HusseinKhodor03/posture-pad/docs/Functional Decomposition.pdf

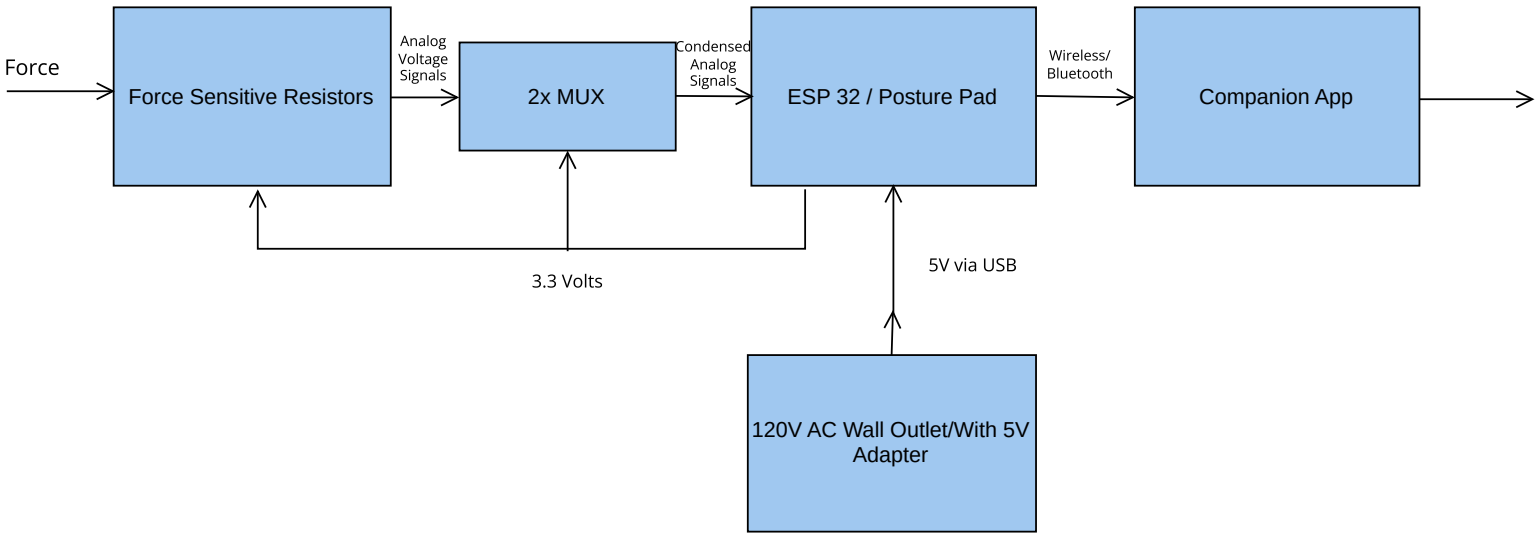
[picture p4: figure]
120V AC Wall Outlet/With 5V Adapter; Wireless/ Bluetooth; Analog Voltage Signals; Condensed Analog Signals; 5V via USB; 3.3 Volts

Force Sensitive Resistors | 2x MUX | ESP 32 / Posture Pad | Companion App

Display of Mapped Force
Gradient

Input Downward Force

Force Sensitive Resistors

Module | Force Sensitive Resistors

Input

Output

Funtionality Will be used to gather downward force from user standing on it

FSR 402 Range: 0N - 20N
FSR 406 Range: 0N - 20N
Power: 3.3V

MUX

Module | Multiplexers

Input

Output | 1 data Output
Funtionality | To be able to be able use all outputs given from using 18 FSRs.

16 data Input
Power: 2V - 6V

A range of Force ranging
from 0 - 20N

ESP 32

Module | ESP 32

Input

Output | 11 I/O Pins
Funtionality | To gather data from FSRs and use the data for our output display.

Power 3.3V
11 I/O Pins

Companion App

Module | Web Application

Input

Output Mapped gradient display of force

Funtionality

To display for user what their standing patterns are through a mapped gradient of their foot impressions.

USB Input from ESP 32

Power Supply

Module | Power Supply

Input

Output | 3.3V
Funtionality | To be compatible to power our ESP32, MUX's and FSRs.

120VAC through a 3.3V
adapter

Force Applied from Standing

3V Volts

ESP 32 | Display colored gradient
Inputs | - 3V from the Wall outlet - Data from standing on FSR.
Outputs | - Mapped display of color gradient to showing force application.
Functionality | - Input force is used to display on an output color gradient of a user's standing patterns and foot impressions.
