HusseinKhodor03/posture-pad/hardware/pcb/Posture Pad PCB CAD.pdf

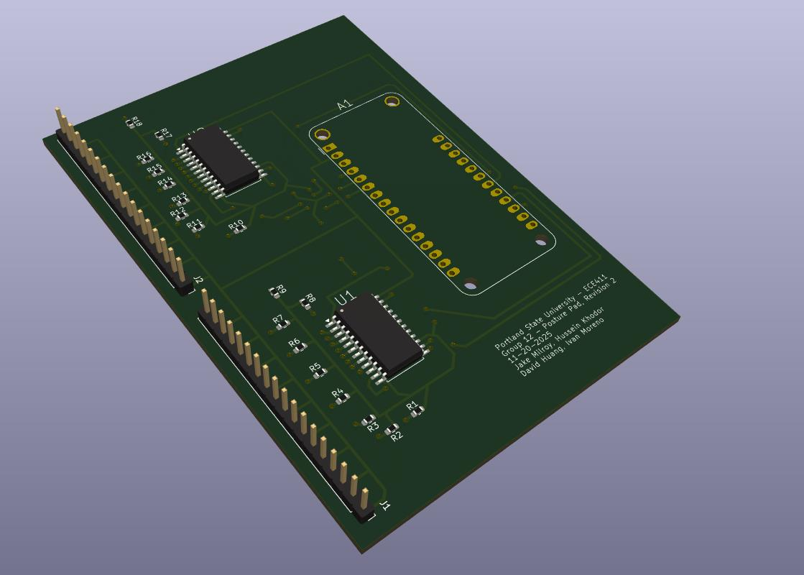
[picture p6: page 1]
