HusseinKhodor03/posture-pad/docs/Bill of Materials.xlsx

Bill Of Materials for: Team 12 - Posture Pad
Last modified: 2025-11-11
PCB version: 1.0
BOM revision: 1.0r0
Qty | Reference Designators | Mfr | Mfr Part Number | Description | Dist | Dist Part Number | Cost Ea. | Cost Total
12 | FSR 402 | Interlink Electronics | 30-81794 | Small, round force-sensitive resistor for pressure sensing | Digi-Key | 1027-1001-ND | $6.39 | $76.68
15 | FSR 406 | Interlink Electronics | 30-73258 | Larger, rectangular force-sensitive resistor for wider-area pressure sensing | Digi-Key | 1027-1002-ND | $10.08 | $151.20
1 | Foam Pad | McMASTER-CARR | 7756T122 | Soft layer providing cushioning and even pressure distribution for the sensing surface | McMASTER-CARR | 7756T122 | $23.88 | $23.88
2 | Plastic Sheets | McMASTER-CARR | 85815K221 | Rigid layers used to protect sensors and help distribute applied force evenly | McMASTER-CARR | 85815K221 | $3.08 | $6.16
4 | Analog/Digital MUX Breakout | SparkFun | CD74HC4067 | 16-channel analog/digital multiplexer for expanding input or output pins | SparkFun | CD74HC4067 | $6.50 | $26.00
 |  |  |  |  |  |  | TOTAL: | $283.92
VERSION INFO
Rev | Date
1.0r0 | 2025-11-11
