HusseinKhodor03/posture-pad/hardware/schematic/Posture Pad Updated Schematic.pdf

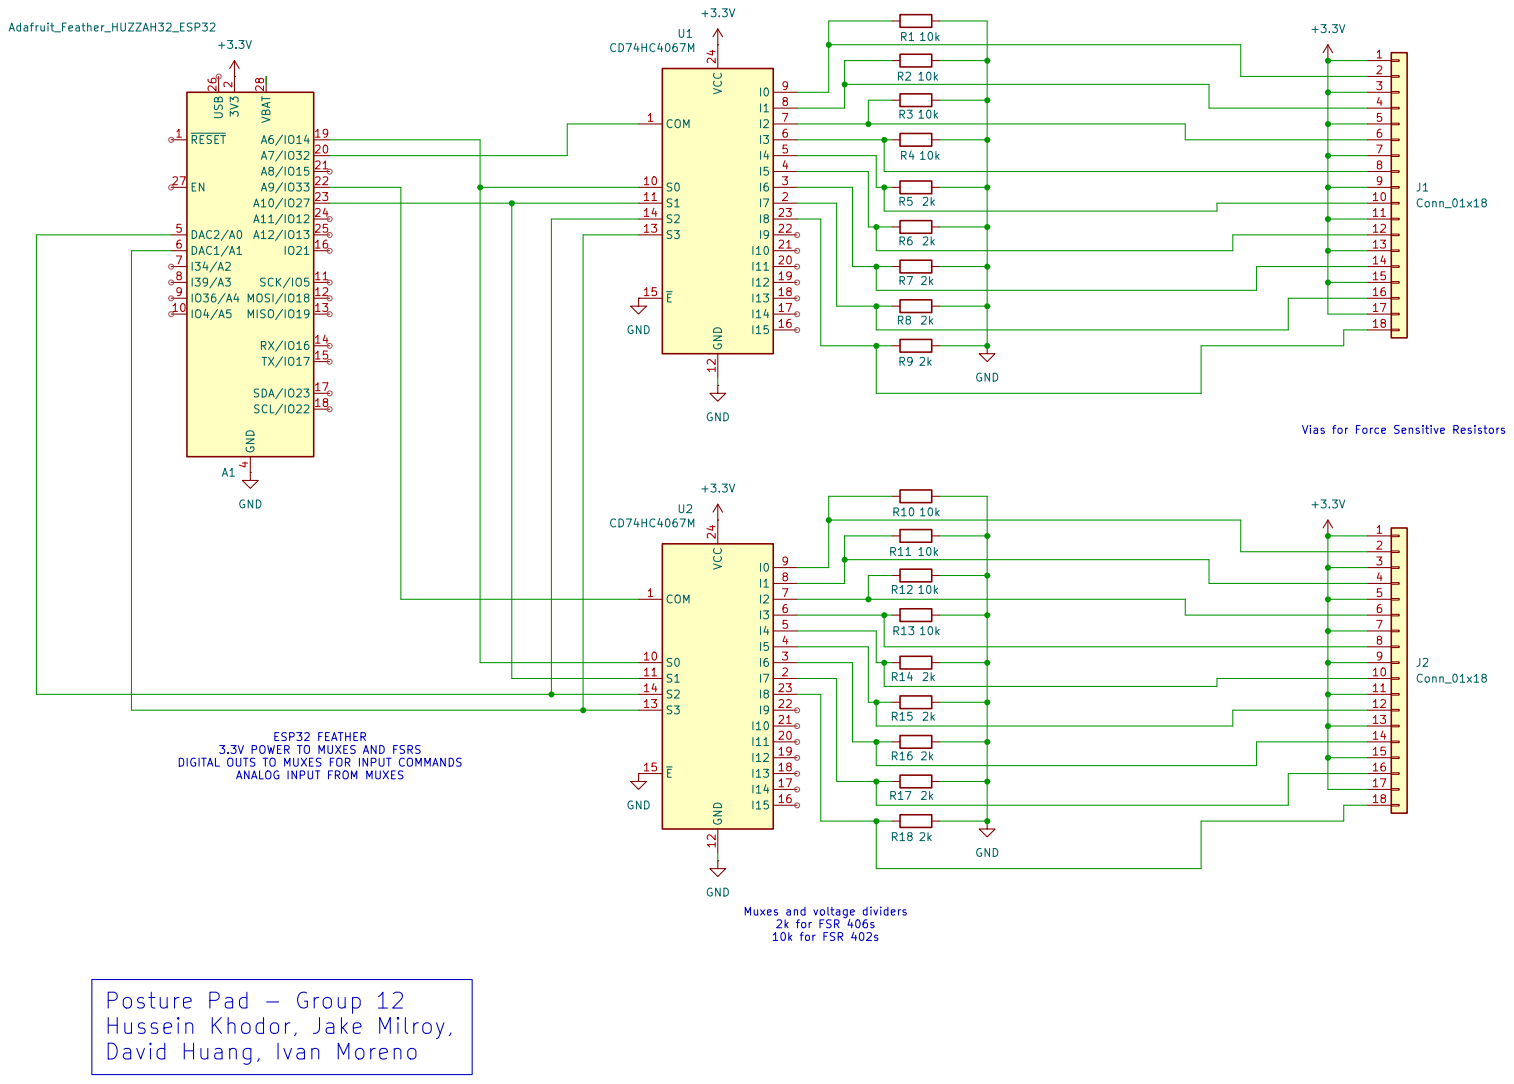
[picture p9: page 1]
