HusseinKhodor03/posture-pad/hardware/schematic/Posture Pad Preliminary Schematic.pdf

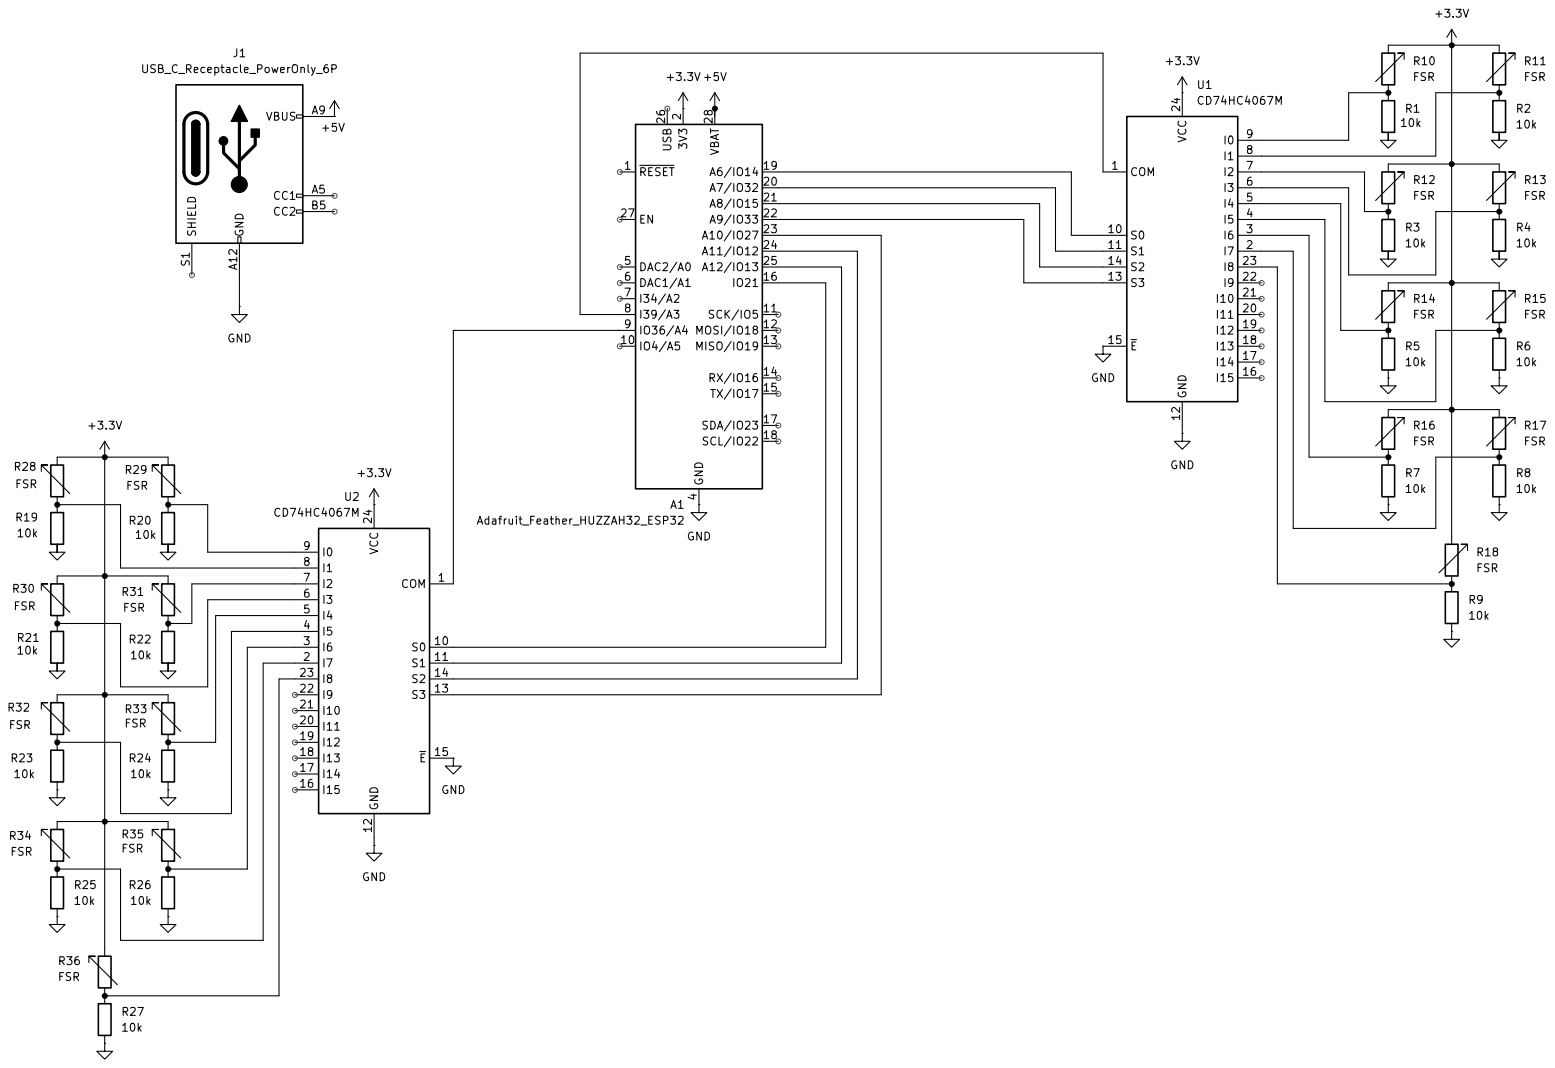
[picture p10: page 1]
