HusseinKhodor03/posture-pad/hardware/kicad/PosturePad/PosturePad.kicad_pcb

## KiCad design hardware/kicad/PosturePad/PosturePad.kicad_pcb (2025-11-22)

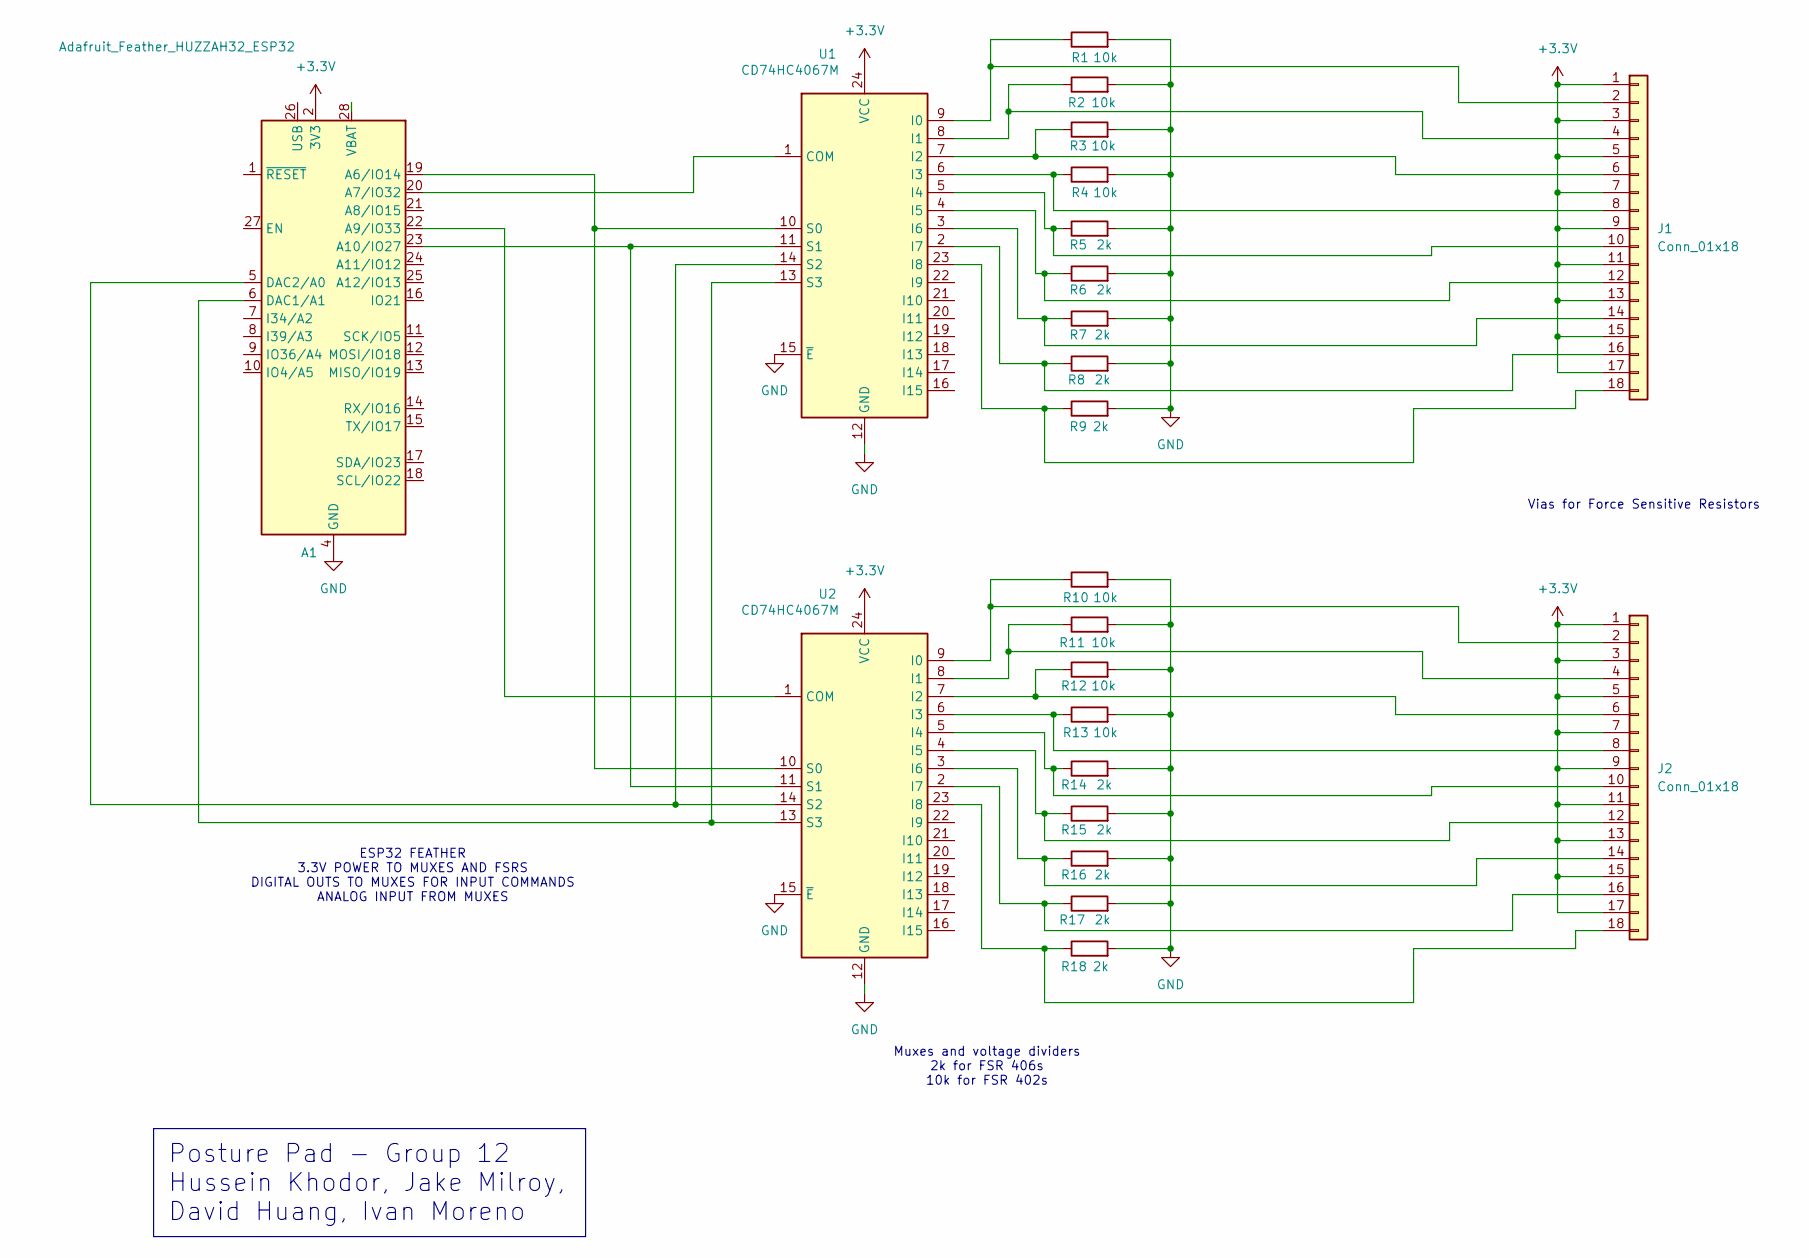
[picture p11: schematic PosturePad.kicad_sch, Posture Pad - Group 12]

Parts:
A1: Adafruit_Feather_HUZZAH32_ESP32; Adafruit_Feather_WithMountingHoles
J1, J2: Conn_01x18; PinHeader_1x18_P2.54mm_Vertical
R1, R2, R3, R4, R10, R11, R12, R13: 10k; R_0603_1608Metric
R5, R6, R7, R8, R9, R14, R15, R16, R17, R18: 2k; R_0603_1608Metric
U1, U2: CD74HC4067M; SOIC-24W_7.5x15.4mm_P1.27mm

Connections:
+3.3V: A1.2 (3V3), J1.1, J1.3, J1.5, J1.7, J1.9, J1.11, J1.13, J1.15, J1.17, J2.1, J2.3, J2.5, J2.7, J2.9, J2.11, J2.13, J2.15, J2.17, U1.24 (VCC), U2.24 (VCC)
GND: A1.4 (GND), R1.2, R2.2, R3.2, R4.2, R5.2, R6.2, R7.2, R8.2, R9.2, R10.2, R11.2, R12.2, R13.2, R14.2, R15.2, R16.2, R17.2, R18.2, U1.12 (GND), U1.15 (~E), U2.12 (GND), U2.15 (~E)
unnamed: A1.19 (A6/IO14), U1.10 (S0), U2.10 (S0)
unnamed: A1.20 (A7/IO32), U1.1 (COM)
unnamed: A1.22 (A9/IO33), U2.1 (COM)
unnamed: A1.23 (A10/IO27), U1.11 (S1), U2.11 (S1)
unnamed: A1.6 (DAC1/A1), U1.13 (S3), U2.13 (S3)
unnamed: A1.5 (DAC2/A0), U1.14 (S2), U2.14 (S2)
unnamed: J1.2, R1.1, U1.9 (I0)
unnamed: J1.4, R2.1, U1.8 (I1)
unnamed: J1.6, R3.1, U1.7 (I2)
unnamed: J1.8, R4.1, U1.6 (I3)
unnamed: J1.10, R5.1, U1.5 (I4)
unnamed: J1.12, R6.1, U1.4 (I5)
unnamed: J1.14, R7.1, U1.3 (I6)
unnamed: J1.16, R8.1, U1.2 (I7)
unnamed: J1.18, R9.1, U1.23 (I8)
unnamed: J2.2, R10.1, U2.9 (I0)
unnamed: J2.4, R11.1, U2.8 (I1)
unnamed: J2.6, R12.1, U2.7 (I2)
unnamed: J2.8, R13.1, U2.6 (I3)
unnamed: J2.10, R14.1, U2.5 (I4)
unnamed: J2.12, R15.1, U2.4 (I5)
unnamed: J2.14, R16.1, U2.3 (I6)
unnamed: J2.16, R17.1, U2.2 (I7)
unnamed: J2.18, R18.1, U2.23 (I8)

Notes on the sheet:
Posture Pad - Group 12 Hussein Khodor, Jake Milroy, David Huang, Ivan Moreno
Muxes and voltage dividers 2k for FSR 406s 10k for FSR 402s
Vias for Force Sensitive Resistors
ESP32 FEATHER 3.3V POWER TO MUXES AND FSRS DIGITAL OUTS TO MUXES FOR INPUT COMMANDS ANALOG INPUT FROM MUXES

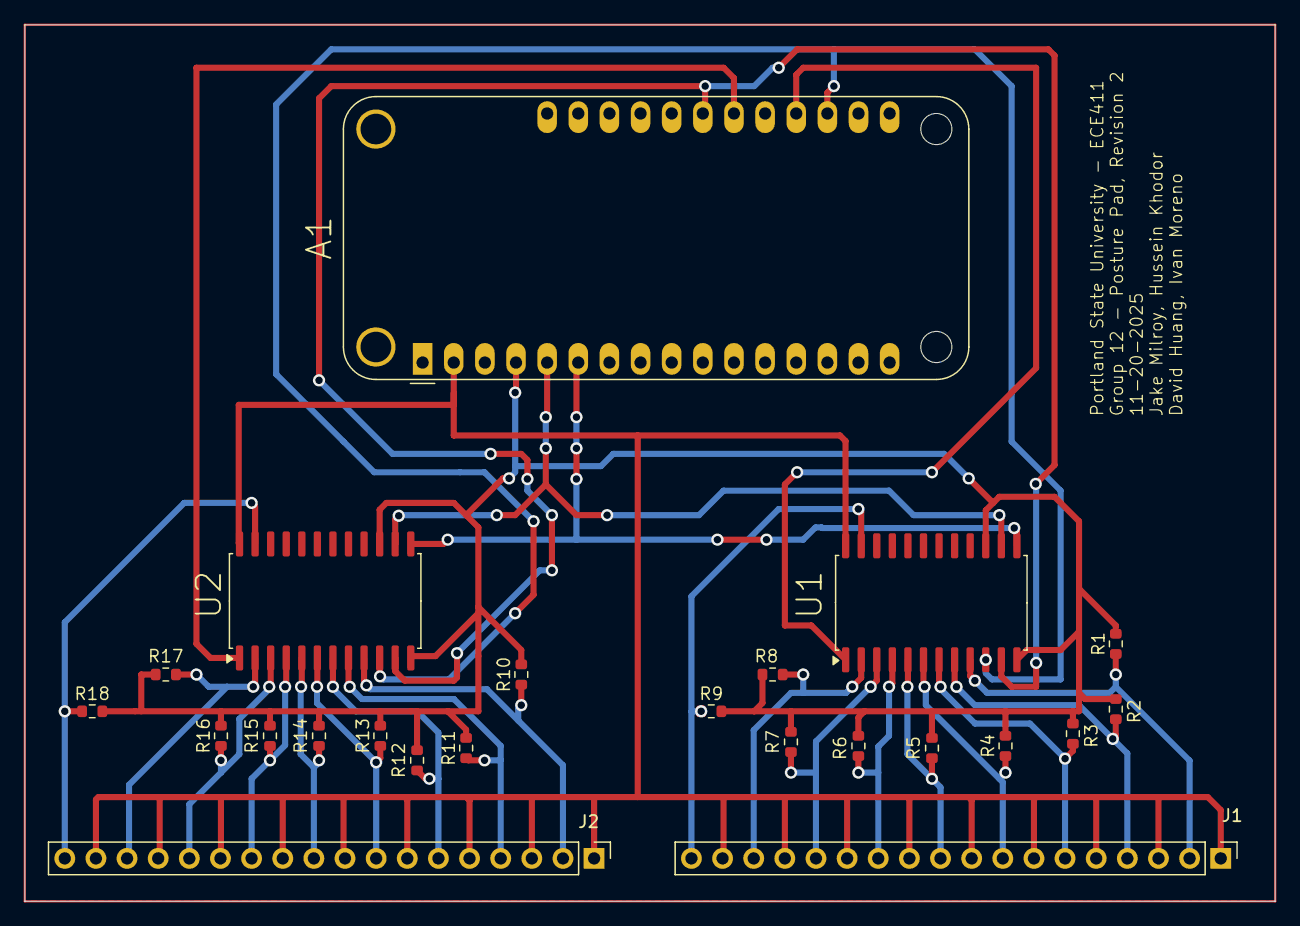
[picture p12: board PosturePad.kicad_pcb from above]

Board: 2 copper layers, 102.0 x 71.5 mm, 23 parts (0 on the bottom side), 26 nets.
