HusseinKhodor03/posture-pad/software/firmware/src/processing/SignalProcessor.cpp

#include "SignalProcessor.h"
#include <math.h>

namespace
{
    constexpr int ADC_MAX = 4095;
    constexpr float VREF = 3.3f;
    constexpr float EMA_ALPHA = 0.3f;
    constexpr float NORMALIZATION_DECAY_RATE = 0.0005f;
    constexpr float MIN_VOLTAGE_RANGE = 0.1f;

    float applyEma(float currentValue, float newValue, float alpha)
    {
        return (alpha * newValue) + ((1.0f - alpha) * currentValue);
    }

    float adcToVoltage(int adcValue)
    {
        return (float)adcValue * (VREF / ADC_MAX);
    }
}

void SignalProcessor::process(SensorData &sensor)
{
    sensor.adcFiltered = applyEma(sensor.adcFiltered, (float)sensor.adcRaw, EMA_ALPHA);
    sensor.voltage = adcToVoltage(sensor.adcFiltered);

    if (sensor.voltage < sensor.voltageMin)
        sensor.voltageMin = sensor.voltage;
    else
        sensor.voltageMin = applyEma(sensor.voltageMin, sensor.voltage, NORMALIZATION_DECAY_RATE);

    if (sensor.voltage > sensor.voltageMax)
        sensor.voltageMax = sensor.voltage;
    else
        sensor.voltageMax = applyEma(sensor.voltageMax, sensor.voltage, NORMALIZATION_DECAY_RATE);

    float range = sensor.voltageMax - sensor.voltageMin;
    if (range < MIN_VOLTAGE_RANGE)
        range = MIN_VOLTAGE_RANGE;

    sensor.normalized = (sensor.voltage - sensor.voltageMin) / range;
    sensor.normalized = sqrt(sensor.normalized);

    if (sensor.normalized < 0.0f)
        sensor.normalized = 0.0f;
    if (sensor.normalized > 1.0f)
        sensor.normalized = 1.0f;
}
