HusseinKhodor03/posture-pad/(commit log)

2025-11-04 Added the preliminary schematic document
2025-11-15 Added the bill of materials document
    [Bill of Materials.xlsx]
2025-11-19 Added the breadboard prototype document
2025-11-20 Added the updated schematic document
2025-11-22 Added the PCB CAD design
2025-11-22 Moved the breadboard prototype image from docs folder to hardware folder
2025-11-22 Removed old posturepad kicad files
2025-11-22 Added a kicad folder with the kicad project files as well as the gerber and drill files
    [PosturePad-B_Cu.gbr, PosturePad-B_Mask.gbr, PosturePad-B_Paste.gbr, PosturePad-B_Silkscreen.gbr, PosturePad-Edge_Cuts.gbr, PosturePad-F_Cu.gbr, PosturePad-F_Mask.gbr, PosturePad-F_Paste.gbr]
2026-06-21 Added ESP32 firmware and posture pad dashboard
2026-07-03 Added BLE device advertising
2026-07-03 Added frontend BLE device connection
2026-07-11 Added device ID to sensor data
2026-07-11 Added device WebSocket subscription
2026-07-11 Added device-specific sensor data routing
2026-07-11 Prepared Node server for Railway deployment
2026-07-12 Connected application to Railway endpoints
2026-07-12 Redirect Railway homepage to frontend site
2026-07-17 Refactor device ID handling into separate module and update main script
2026-07-20 Refactor heatmap rendering into HeatmapRenderer class and update main script
2026-07-20 Refactor device ID normalization logic into separate module
2026-07-25 Increased firmware sensor update rate
2026-07-25 Reset posture metrics and analysis when not standing
    [MetricsCalculator.cpp, PostureAnalyzer.cpp]
2026-07-25 Added showWaitingDashboardState function to update dashboard UI when waiting for device
2026-07-26 Track dashboard online status from sensor stream
2026-07-26 Added URL-based device selection and dashboard status pill
2026-07-26 Reset heatmap sensor data when dashboard status is offline
2026-07-26 Fixed heatmap initialization on hidden dashboard tab
2026-07-27 Fixed tab reload state and heatmap loading flicker
2026-07-29 Redesign config tab as single setup flow
2026-08-02 Added device switching functionality
2026-08-02 Polish forget network button
2026-08-03 Keep current Wi-Fi network visible during stream drops
2026-08-03 Added device ID display in configuration header
2026-08-03 Clear selected device when BLE session ends
2026-08-03 Added button hover animation
2026-08-04 Reset setup flow when switching devices
2026-08-15 Finalize device setup controller refactor
2026-08-16 Extract foot heatmaps coordinator
2026-09-27 Separate sensor voltage default from ADC reference
2026-09-28 Extract firmware device identity
2026-09-28 Remove status LED behavior
