HusseinKhodor03/posture-pad/hardware/prototype/Breadboard Prototype.jpg

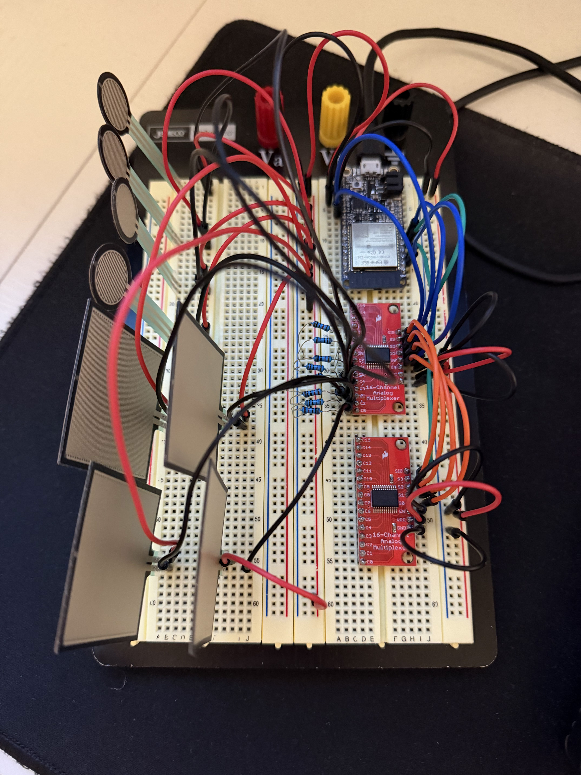
hardware/prototype/Breadboard Prototype.jpg
